spbkaizo/baudio/images/render.png

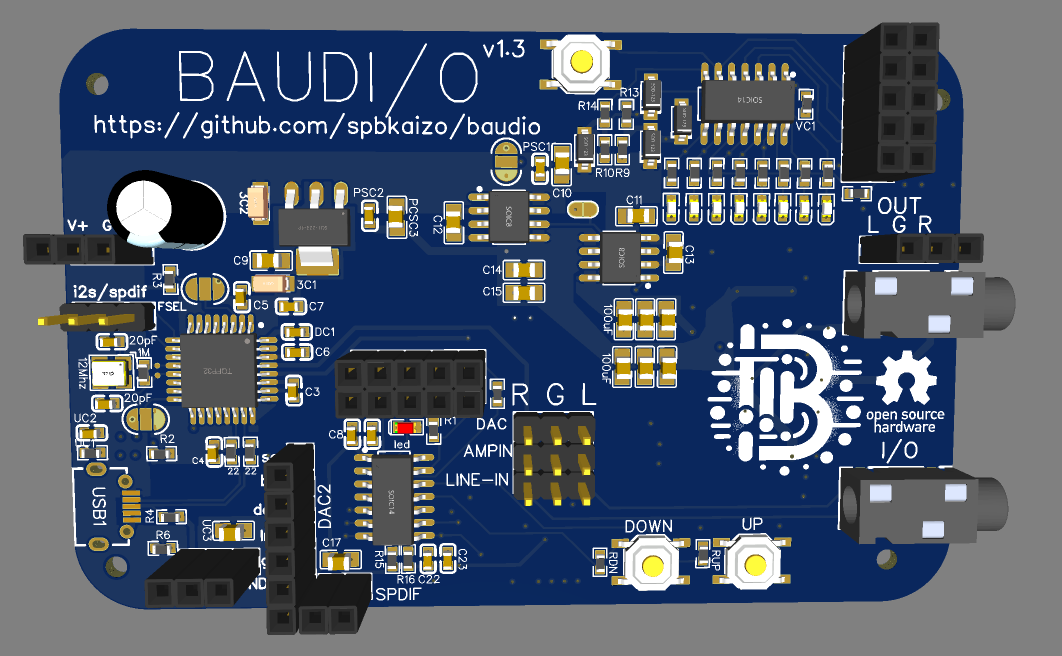
images/render.png
