spbkaizo/baudio/bom/BOM_BAUDIO_2024-05-25.csv

ID | Name | Designator | Footprint | Quantity | Manufacturer Part | Manufacturer | Supplier | Supplier Part | Price
1 | 10u | 3C1,3C2,BC1+,BC1-,VC4+,VC4- | CASE-A_3216 | 6 | CA45B-A-10V-10uF-K | CEC(振华新云) | LCSC | C136812 | 0.076
2 | LM2663MX/NOPB | 2663-1,2663-2 | SOIC-8_L4.9-W3.9-P1.27-LS6.0-BL | 2 | LM2663MX/NOPB | TI(德州仪器) | LCSC | C73869 | 2.647
3 | PCM2706CPJT | 2706 | TQFP-32_L7.0-W7.0-P0.80-LS9.0-BL | 1 | PCM2706CPJT | TI(德州仪器) | LCSC | C1520003 | 9.79
4 | HDR-F-2.54_2x5 | A1614VOL | HDR-F-2.54_2X5 | 1 |  |  | LCSC | C30419 | 0.055
5 | AD5242BRZ10-REEL7 | AD5242 | SOIC-16_L9.9-W3.9-P1.27-LS6.0-BL | 1 | AD5242BRZ10-REEL7 | ADI(亚德诺) | LCSC | C649396 | 4.785
6 | HDR-M-2.54_1x3 | AMPIN,DAC,FSEL,LINE-IN | HDR-M-2.54_1X3 | 4 |  |  | LCSC | C180248 | 0.175
7 | ATTINY1614-SSF | AT1614VOL,AT1614VU | SOIC-14_L8.7-W3.9-P1.27-LS6.0-BL | 2 | ATTINY1614-SSF | MICROCHIP(美国微芯) | LCSC | C614831 | 1.388
8 | 0.1u | BC2+,BC2-,PSC1,PSC2 | C0603 | 4 | 06035C104KAT2A | Kyocera AVX | LCSC | C88476 | 0.007
9 | Solder Short | BL,BR,SH3,SH4,SH5,SH6 | SOLDER SHORTING | 6
10 | 715 | BR2,LR1,LR2,RR1 | R0603 | 4 | 0603WAF7150T5E | UNI-ROYAL(厚声) | LCSC | C23238 | 0.001
11 | 100 | BR3,LR3 | R0603 | 2 | RT0603BRD07100RL | YAGEO(国巨) | LCSC | C122970 | 0.018
12 | 20p | C1,C2 | C0603 | 2 | AC0603JRNPO9BN200 | YAGEO(国巨) | LCSC | C149610 | 0.005
13 | 1uF | C1L,C1R,C2L,C2R | C1210 | 4 | ECPU1C105MA5 | PANASONIC(松下) | LCSC | C569895 | 0.398
14 | 1u | C3,C4,C5,C6 | C0603 | 4 |  |  | LCSC | C95843 | 0.007
15 | 22pf | C4L,C4R | C0603 | 2 | CC0603JRNPO9BN220 | YAGEO(国巨) | LCSC | C105620 | 0.002
16 | 0.1u | C7 | C0603 | 1 | CC0603MRY5V8BB104 | YAGEO(国巨) | LCSC | C519502 | 0.004
17 | 0.1u | C8,C23 | C0603 | 2 | ECPU1C104MA5 | PANASONIC(松下) | LCSC | C150376 | 0.256
18 | 1u | C9,C10,C11 | C0805 | 3 |  |  | LCSC | C95843 | 0.007
19 | 47u | C12,C13,C14,C15 | C0805 | 4 | CC0805MKX5R5BB476 | YAGEO(国巨) | LCSC | C109461 | 0.059
20 | 1u | C16,C22 | C0603 | 2 | CC0603KRX7R7BB105 | YAGEO(国巨) | LCSC | C106248 | 0.008
21 | 10u | C17,C18,C21 | C0805 | 3 | CGA0805X5R106K500MT | HRE(芯声) | LCSC | C6119889 | 0.058
22 | BZT52B4V7 | D1,D2,D3,D4 | SOD-123_L2.7-W1.6-LS3.7-RD | 4 |  |  | LCSC | C968129 | 0.019
23 | DAC2 | DAC2 | HDR-F-2.54_1X6 | 1 | 2.54-1*6P母 | BOOMELE(博穆精密) | LCSC | C40877 | 0.07
24 | 10u | DC1 | C0603 | 1 |  |  | LCSC | C19702 | 0.005
25 | 0 | DL1,DR1 | R0603 | 2
26 | HX TS5216A 250GF | DOWN,UP,VU-CTL | SW-SMD_4P-L5.2-W5.2-P3.70-LS6.4 | 3 | HX TS5216A 250gf | hanxia(韩下) | LCSC | C5143639 | 0.013
27 | HDR-F-2.54_1x3 | DUAL,H2 | HDR-F-2.54_1X3 | 2 |  |  | LCSC | C146690 | 0.076
28 | 0R | GND1,GND2 | R0603 | 2 | 0603WAF0000T5E | UNI-ROYAL(厚声) | LCSC | C21189 | 0.001
29 | HDR-F-2.54_2x5 | H1 | HDR-F-2.54_2X5 | 1 | DS1023-2*5SF11 | CONNFLY | LCSC | C92270 | 0.104
30 | Black headphone jack | I/O,OUT | AUDIO-TH_PJ-3200 | 2 | 320B直插 | BOOMELE(博穆精密) | LCSC | C18166 | 0.051
31 | SD | JP1,JP2,JP3 | SOLDER BRIDGE 3P UNBRIDGED | 3
32 | 10nF | LC1,LC2,RC1,RC2 | C0805 | 4 |  |  | LCSC | C178414 | 0.217
33 | KPH-1608SECK | LED1,LED2,LED3,LED4,LED5,LED6,LED7,LED8 | LED0603-RD | 8 | XL-1608UVC-04 | XINGLIGHT(成兴光) | LCSC | C7371898 | 0.01
34 | LED-0603_R | LED9 | LED0603_RED | 1 | KPH-1608SECK | Kingbright | LCSC | C5879293 | 0.118
35 | LM1117GS-3.3-HTC | LM1117 | LM1117GS-3.3-HTC-SOT-223 | 1 | LD1117AG-33-AA3-A-R | UTC | LCSC | C71121 | 0.062
36 | HDR-M-2.54_1x3 | OUT2 | HDR-F-2.54_1X3 | 1 |  |  | LCSC | C180248 | 0.175
37 | 10u | PCSC3,UC3 | C0805 | 2 | CL21A106KOQNNNE | SAMSUNG(三星) | LCSC | C1713 | 0.008
38 | 1k | R1 | R0603 | 1 |  |  | LCSC | C203217 | 0.003
39 | 100k | R1L,R1R,R2L,R2R | R0603 | 4 | ERA6AEB104V | PANASONIC(松下) | LCSC | C192074 | 0.071
40 | 10k | R2,RDN | R0603 | 2 | HoAR0603-1/10W-10KR-0.1%-TCR25 | Milliohm(毫欧) | LCSC | C5123581 | 0.074
41 | 10K | R3,R22,RUP | R0603 | 3
42 | 1k | R3L,R3R,RLED1,RLED2,RLED3,RLED4,RLED5,RLED6,RLED7,RLED8 | R0603 | 10 | CR0603-FX-1001ELF | BOURNS | LCSC | C203217 | 0.003
43 | 1k5 | R4 | R0603 | 1 | RC0603FR-071K5L | YAGEO(国巨) | LCSC | C114668 | 0.001
44 | 2.8k | R4L,R4R | R0603 | 2 | CMP0603AFX-1002ELF | BOURNS | LCSC | C1880697 | 0.278
45 | 470 | R5,R17 | R0603 | 2 | CR0603F470RP05Z | EVER OHMS(天二科技) | LCSC | C881392 | 0.002
46 | 100 | R5L,R5R | R0603 | 2 | QR0603J0R00P05Z | EVER OHMS(天二科技) | LCSC | C176152 | 0.003
47 | 1M | R6,X1R | R0603 | 2 | SCR0603F1M | VO(翔胜) | LCSC | C3016422 | 0.001
48 | 100k | R7,R8 | R0603 | 2 | RT0603BRE07100KL | YAGEO(国巨) | LCSC | C326758 | 0.023
49 | 10k | R9,R10,R11,R12,R13,R14,R20,R21 | R0603 | 8 | ERJ3EKF1002V | PANASONIC(松下) | LCSC | C191124 | 0.005
50 | 4.7K | R15,R16 | R0603 | 2 | ERJ3EKF4701V | PANASONIC(松下) | LCSC | C192166 | 0.004
51 | 1k | R18,R19 | R0603 | 2
52 | HDR-F-2.54_1x2 | SPDIF | HDR-F-2.54_1X2 | 1 |  |  | LCSC | C124375 | 0.022
53 | 0.1u | UC1,VC1 | R0603 | 2 | ECPU1C104MA5 | PANASONIC(松下) | LCSC | C150376 | 0.256
54 | 1u | UC2,VC5+,VC5- | C0603 | 3 | 06033D105MAT2A | Kyocera AVX | LCSC | C597124 | 0.032
55 | HX USB-MICR XNJ ZB | USB1 | MICRO-USB-SMD_HX-USB-MICRO-XNJ-JB | 1 | HX USB-MICR XNJ ZB | hanxia(韩下) | LCSC | C18357557 | 0.028
56 | 680uF | USBC1 | CAP-D6.3×F2.5 | 1 |  |  | LCSC | C2990893 | 0.095
57 | 22 | USBR1,USBR2 | R0603 | 2 | RTT0322R0FTP | RALEC(旺诠) | LCSC | C103434 | 0.001
58 | 100u | VC1+,VC1-,VC2+,VC2-,VC3+,VC3- | C0805 | 6 |  |  | LCSC | C141660 | 0.358
59 | 0.1u | VC6+,VC6- | C0603 | 2 |  |  | LCSC | C88476 | 0.007
60 | 12MHz | X1 | OSC-SMD_4P-L3.2-W2.5-BL | 1 | X322512MSB4SI | YXC(扬兴晶振) | LCSC | C9002 | 0.057
61 | LM4562MA/NOPB | BUF | SOIC-8_L4.9-W3.9-P1.27-LS6.0-BL | 1 | LM4562MA/NOPB | TI(德州仪器) | LCSC | C1348033 | 5.818
62 | LM4562 | OPA | SOIC-8_L4.9-W3.9-P1.27-LS6.0-BL | 1 | LM4562MAX/NOPB | TI(德州仪器) | LCSC | C57367 | 1.397
