spbkaizo/baudio/(threads)

Thread 1 (2024-11-08):

Suggestion: USB-C Connector

Ardakilic, 2024-11-08:
Hello,

Can the connector be USB-C ? Micro usb connectors tend to break, at least for me, a lot, and I believe with 5.1k ohm resistors included with the connector, regardless of the voltage, PD could negotiate with the board and it could supply 5v, just like micro usb does to the rest of the board.

Thanks in advance,
