spbkaizo/baudio/vu-meter/adc.c

#include "adc.h"
#include <util/delay.h>

#define SAMPLE_COUNT 100

void setup_adc() {
    /* Select the reference before enabling the ADC. REFSEL is a bit group,
       so clear it first: |= alone cannot move the selection off a value that
       is already set, and setup_adc() is called more than once. Options are
       0V55, 1V1, 1V5, 2V5 and 4V34; 4V34 suits the DC-biased audio input on
       this board. */
    VREF.CTRLA = (VREF.CTRLA & ~VREF_ADC0REFSEL_gm) | VREF_ADC0REFSEL_4V34_gc;

    // Set the ADC prescaler to 16 (20 MHz / 16 = 1.25 MHz ADC clock)
    ADC0.CTRLC = ADC_PRESC_DIV16_gc | ADC_REFSEL_INTREF_gc;

    /* Lengthen the sampling period. The default of two ADC clocks is short
       for the high source impedance of the audio divider feeding these
       inputs, which leaves the sample capacitor incompletely charged and the
       reading low. */
    ADC0.SAMPCTRL = 16;

    // Enable the ADC
    ADC0.CTRLA = ADC_ENABLE_bm;
}

uint16_t read_adc(uint8_t channel) {
    // Select the ADC channel
    ADC0.MUXPOS = channel;

    // Start the conversion
    ADC0.COMMAND = ADC_STCONV_bm;

    // Wait for the conversion to complete
    while (!(ADC0.INTFLAGS & ADC_RESRDY_bm));

    // Clear the interrupt flag
    ADC0.INTFLAGS = ADC_RESRDY_bm;

    // Return the ADC result
    return ADC0.RES;
}

void calibrate_adc_baseline(uint8_t channel, uint16_t *baseline) {
    uint32_t sum = 0;
    uint16_t sample;

    // Take multiple samples
    for (int i = 0; i < SAMPLE_COUNT; i++) {
        sample = read_adc(channel);
        sum += sample;
        _delay_ms(5);  // Delay to allow ADC to settle
    }
    *baseline = sum / SAMPLE_COUNT;
}
