spbkaizo/baudio/vu-meter/spectrum.h

// spectrum.h

#ifndef SPECTRUM_H
#define SPECTRUM_H

#include <stdint.h>

// Initializes the spectrum analyzer module.
void spectrum_init();

// Updates the spectrum analyzer, should be called regularly.
void spectrum_update();

#endif // SPECTRUM_H
