spbkaizo/baudio/(commit log)

2024-03-19 add schematics and gerber for v1.1
2024-03-19 bom still needs work
    [BOM_Bcard2024_2024-03-19.csv]
2024-03-19 added schematics to docs
2024-03-20 added pcb
2024-03-20 added pcb to main page
2024-03-20 fixed up and finalised bom
    [BOM_BAUDIO_v1.1.xlsx, BOM_Bcard2024_2024-03-19.csv]
2024-03-20 fix out of stock item in bom
    [BOM_BAUDIO_v1.1.xlsx]
2024-03-23 added PCM5102A datasheet for breakout board
2024-03-29 update schematic
2024-03-30 pull gerber - design broken
2024-05-17 add some datasheets, add circuitjs amp
2024-05-17 add circuitjs link
2024-05-17 update to v1.3 schematics
2024-05-22 added usart adc debugger, extended vu-meter code
2024-05-24 moved to Voltage reference at 4.34V for the VU meter - seems to give a better response.
2024-05-25 Resync gerbers and update docs
2024-05-25 Update BOM
    [BOM_BAUDIO_2024-05-25.csv, BOM_BAUDIO_v1.1.xlsx]
2026-09-16 fixfft: populate the missing Sinewave table
    The table was left as a placeholder comment, so all 192 entries were
    zero. Every twiddle factor read by fix_fft() was therefore 0 and the
    transform returned garbage, making spectrum analyzer mode inoperable.
    Generated as round(127 * sin(2*pi*i / N_WAVE)) for i in 0..191, which
    is the table the original fix_fft expects: peak +127 at index 64 and a
    zero crossing at index 128, so the cosine term read at the N_WAVE/4
    offset lines up correctly.
    [fixfft.c]
2026-09-16 timer: stop millis() from unconditionally re-enabling interrupts
    millis() ended its critical section with sei() rather than restoring
    the previous interrupt state. It is called from inside
    PORTB_PORT_vect, where that sei() re-enables interrupts within the
    handler and allows the button ISR to re-enter itself, nesting until
    the stack is exhausted. A bouncing switch was enough to trigger it.
    Save SREG on entry and restore it after the read, so the flag is left
    as the caller had it.
2026-09-16 volume-control: check I2C acknowledgement and bound the wait loops
    i2c_start() and i2c_write() spun on TWI_WIF_bm without ever testing
    RXACK, ARBLOST or BUSERR, so a device that failed to acknowledge left
    the firmware spinning forever with the bus still held. Both now report
    failure, every wait is bounded by a guard count, and ad5242_set_wiper()
    always issues a STOP so a failed transfer releases the bus.
    MBAUD used (F_CPU - 2*f_SCL) / (2*f_SCL), which is not the tinyAVR
    formula and gave 15. The datasheet expression F_CPU/(2*f_SCL) - 5
    gives 11, for roughly 98 kHz.
    current_index becomes uint8_t and the array bound moves to a named
    VOLUME_STEPS constant, silencing a signed/unsigned compariso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
    [main.c]
2026-09-16 vu-meter: build vu2.c instead of vu1.c
    main.c includes vu2.h and calls volume_meter_task() with two channel
    arguments, but the Makefile compiled vu1.c, whose volume_meter_task()
    takes one. Both files define the same two symbol names, so the linker
    bound the two-argument call to the one-argument function without
    complaint: the right-channel argument was passed in a register the
    callee never read, and all eight LEDs were driven from the left
    channel against baseline_left alone.
    Building vu2.c gives the intended split display, LEDs 0-3 for left and
    4-7 for right, each against its own calibrated baseline.
    Verified on target: avr-gcc -mmcu=attiny1614 links clean at 5876 bytes
    flash (36%) and 63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
2026-09-16 build: point both Makefiles at the Microchip ATtiny DFP
    avr-gcc has no built-in support for the tinyAVR 0/1-series, so
    building for the ATtiny1614 failed with "device type not defined" and
    every register name came back undeclared. The device specs and headers
    come from Microchip's ATtiny DFP instead.
    Both Makefiles now pass -B $(DFP)/gcc/dev/$(MCU) and -isystem
    $(DFP)/include, defaulting to ~/local/avr-dfp and overridable with
    make DFP=/path/to/pack. -Wall is on for both, vu-meter links -lm for
    the sqrt and log10 calls in spectrum.c, and the stale AVR_LIBC_PATH
    that pointed at a non-existent tree is gone.
    make now produces a flashable main.hex in both projects.
    Object files, ELF and listi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
2026-09-16 spectrum: stop writing brightness values into a one-bit LED API
    set_led_state() ORs its argument into PORTA/PORTB at the LED's bit
    position, so it must be passed 0 or 1. spectrum_update() passed a
    0-255 magnitude, and (state << PIN1_bp) then spilled across unrelated
    pins: a magnitude of 255 set PORTB bits 1-7, which includes PB3, the
    mode button input, and PB7. A magnitude of 128 shifted clean off the
    top of the byte and left the LED dark at full scale.
    The bin-to-LED mapping was wrong as well. Folding 128 bins onto 8 LEDs
    with i % LED_COUNT meant each LED was written 16 times per frame and
    kept only the last write, so the display showed bins 120-127 alone,
    the top of the spectrum. Bins are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
    [main.c, spectrum.c, spectrum.h]
2026-09-16 adc-debug: fix USART baud rate calculation and TX/RX pins
    The baud register used the classic ATmega expression
    F_CPU/(16*baud) - 1, which gave 9. On the tinyAVR 0/1-series BAUD is a
    16-bit value with six fractional bits, so 9 asks for roughly 8.9 Mbaud
    against a target of 115200. The correct expression, 64*F_CPU/(16*baud),
    gives 694 for 115274 baud, an error of 0.06 percent. The & 0x0FFF mask
    would have truncated that value and is gone.
    usart_init() also drove PA1 and PA2, which carry no USART signal on
    this part. The device definition puts USART0 TXD on PB2 and RXD on PB3
    in the default port mux position, so nothing was ever transmitted.
    The local #define F_CPU is removed; it appeared aft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
    [usart.c]
2026-09-16 adc: write the reference select as a field and lengthen sampling
    VREF.CTRLA was written with |=, which cannot move REFSEL off a value
    that is already set because the field is three bits wide, not a flag.
    It happened to produce 4V34 from the reset state, but setup_adc() runs
    more than once and any later change of reference would have silently
    OR-ed into a wrong selection. The field is now masked before the write.
    The reference is also selected before the ADC is enabled, and
    SAMPCTRL extends the sampling period beyond the two-clock default,
    which is short for the source impedance of the audio divider driving
    these inputs and biases readings low.
    spectrum_init() no longer calls setup_adc(). m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
    [adc.c, spectrum.c]
2026-09-16 vu-meter: wrap the mode counter at the number of modes compiled in
    The button handler advanced the mode with a hardcoded % 5. That is
    right for the five LED modes, but a USE_LCD build has only three, so
    the counter could reach 3 and 4, which no case in the LCD switch
    handles. The display then stopped updating until the button was
    pressed enough times to wrap past them.
    MODE_COUNT is defined alongside the mode list in main.h and follows
    whichever set is compiled in, five or three.
    Removes last_state, which was declared volatile and never read.
    Verified both paths build for the target; the USE_LCD preprocessor
    output resolves the wrap to % 3.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
    [main.c, main.h]
2026-09-16 cylon: drive the LEDs through set_led_state and wire up middle-out
    cylon.c was compiled into every build but never called: MODE_MIDDLE_OUT
    ran the volume meter instead, so the fifth mode duplicated the second.
    The effect also wrote PORTA directly, setting PA1 to PA5. The eight
    LEDs are split across two ports and are not in pin order, so those
    writes lit the wrong LEDs, missed the one on PA6, and never touched
    the two on PORTB. It now goes through set_led_state() like every other
    effect.
    Rewritten as the middle-out sweep the mode name describes: the two
    centre LEDs light first and the mirrored pair moves outwards to the
    ends, then back in. The loops poll mode so a button press leaves the
    ef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
    [cylon.c, main.c]
2026-09-16 lcd: record the column count and clamp the cursor column
    lcd_begin() took cols and ignored it, so lcd->cols held whatever
    lcd_init() had already stored and the parameter was dead. It is now
    assigned there as well, which makes lcd_begin() usable on its own.
    lcd_set_cursor() clamped row but not col, so a column past the end of
    the line walked the DDRAM address into the next row's buffer. Both are
    clamped now.
2026-09-16 vu-meter: rectify before averaging and stop the level wrapping
    Two faults in the level calculation.
    The lit-LED count was computed as abs(normalized) * 4 / SENSITIVITY and
    cast to uint8_t with nothing clamping it. The product passes 255 once
    the deviation reaches 192 counts, so the cast wrapped and a loud
    passage blanked the meter at the moment it should have been full. It
    then cycled through the range as the signal rose further. The count is
    now computed in a wider type and saturates at four LEDs per channel.
    The window also averaged raw samples and subtracted the baseline
    afterwards, which lets the halves of the waveform cancel according to
    where the window falls in the cycle. Each sampl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
2026-09-16 fixfft: clamp FIX_MPY and take int8_t rather than char
    FIX_MPY returned the rounded product without a range check. With both
    operands at -128 the rounded value is +128, which does not fit in a
    signed 8-bit result and wraps to -128, inverting the sign inside the
    butterfly. One operand always comes from the sine table, whose
    magnitude never exceeds 127, so the case is not reachable today, but
    the biased sample range does include -128 and the clamp is cheap.
    The signature moves from char to int8_t. Plain char has
    implementation-defined signedness, and the arithmetic here relies on
    it being signed.
    Verified against the C logic in a host model: pure tones at bins 4, 8,
    16 and 32 each produce th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
    [fixfft.h]
2026-09-16 volume-control: only step the volume on a write the pot acknowledged
    The LED was lit on any press, before the range check, so it signalled
    success at the ends of the travel where nothing moved and when the pot
    never acknowledged. It now flashes only when a step actually took
    effect, which makes it a usable indication that the I2C write landed.
    current_index is advanced only after apply_volume() reports success.
    Incrementing first left the stored index describing a wiper position
    the device had never taken, and every later step compounded it.
    Pressing both buttons together took whichever branch was tested first;
    that combination is now ignored.
    The pin comments named the opposite button fo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
2026-09-16 adc: correct the channel comment and record the right-channel conflict
    Both headers labelled AIN10 as PB2. The device definition puts AIN10
    on PB1; PB2 has no ADC channel on this part, whose analogue inputs are
    AIN0-AIN7 on PA0-PA7 plus AIN10 on PB1 and AIN11 on PB0.
    That leaves the right channel wrong in two independent ways. The VU
    meter schematic routes the adcro net to PB2, which cannot be sampled
    at all, while the firmware selects AIN10, which is PB1, a pin main.c
    drives as an output for LED 0. The left channel is consistent: AIN7 is
    PA7 and the schematic agrees.
    No behaviour is changed. Selecting a different channel without the
    board in hand would only move the problem to another wro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
    [adc.h]
2026-09-16 docs: record the v1.4 board faults found while fixing the firmware
    HARDWARE-ISSUES.md captures two findings from tracing the VU meter
    schematic against the ATtiny1614 device definition, so they are not
    re-derived later.
    HW-1: the sheet routes the right channel net adcro to PB2, which has
    no ADC channel on this part. The firmware independently selects AIN10,
    which is PB1, a pin driven as an output for LED 0. Both are wrong, and
    every ADC-capable pin is already committed, so a fix has to give
    something up. Four options are set out with a recommendation: move the
    right channel to PB1 and put that LED on PB2, which needs one net swap
    and one line of firmware.
    HW-2: PB2 is also the default USAR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
    [usart.c]
2026-09-16 ci: build the firmware and publish the hex files
    Builds all three ATtiny1614 projects on push, pull request and manual
    dispatch. Every run uploads the hex files as artefacts; pushing a
    version tag also attaches them to a GitHub Release with flashing
    instructions, which is the copy meant for distribution.
    avr-gcc cannot target the tinyAVR 0/1-series on its own, so the job
    fetches Microchip's ATtiny DFP, trims it to the gcc and include trees
    it actually needs, 129 MB down to 16 MB, and caches it against the
    pinned pack version. A small probe compiles a register access before
    the real build, so a toolchain that cannot use the pack reports itself
    rather than appearing as undeclared-register err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
2026-09-16 docs: tell the builder how to program the microcontrollers
    BUILD.md walked through populating the whole board and stopped at
    "Anything Missing?", never mentioning that the two ATtiny1614s arrive
    blank. Someone following it start to finish ended with a finished board
    whose LEDs did nothing and no indication that a programming step
    existed.
    Adds a Stage 2 section covering what a UPDI programmer is, where to get
    the prebuilt .hex files, and the avrdude command for each of the two
    chips, noting they are physically separate and each needs its own
    connection. A Proof of life subsection records what a correctly
    programmed board does at power-up: the volume control blinks BAUDIO in
    Morse, and the V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
2026-09-16 docs: specify the board change that makes the right channel readable
    PCB-REV-1.5.md sets out the single edit for the next board revision:
    swap the nets on pins 7 and 8 of the VU meter ATtiny1614, so the
    adcro audio input lands on PB1, which has an ADC channel, and the
    rled1 LED moves to PB2, which does not need one.
    Covers the reasoning, the steps in EasyEDA, routing notes for the
    analogue line, the firmware changes to make at the same time, and how
    to verify the result on an assembled board. Also records that HW-2,
    the PB2 collision with the serial debug output, is resolved by the
    same change.
    The two firmware changes were applied to a scratch copy and compiled
    for the target to confirm t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
2026-09-18 docs: record what the v1.3 to v1.4 revision fixed
    The v1.4 board added a resistor to ground on each of the two audio
    inputs. On the v1.4 schematic those are R11 and R12, 10k each, which
    pair with R9 and R10 from +5V to bias each VU meter input to mid-rail.
    Without them the input floats high and the ADC has no usable baseline.
    Marked as likely rather than confirmed: the designators are inferred
    from the v1.4 topology and the author's recollection, and no v1.3
    schematic is in this repository to check against.
    The practical consequence is recorded either way. A v1.3 board carries
    this fault as well as HW-1, so it cannot be used to test the right
    channel pin allocation.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
2026-09-18 docs: correct the v1.3 to v1.4 fix and keep a photo of the bodge
    A photograph of a built v1.3 board shows the fix as two hand-soldered
    through-hole resistors on the underside, banded brown-black-orange-gold
    for 10k, joined at one end and fanning to two pads beside the AD5242.
    That places the change on the volume control, not the VU meter. An
    earlier note here guessed R11 and R12 in the VU meter's bias divider
    from the v1.4 schematic alone; the photograph contradicts it. The
    AD5242's B terminals want to sit at ground for the part to work as a
    volume divider, and 10k matches the element value of the AD5242BRZ10
    fitted.
    Still not confirmed against a v1.3 schematic or a netlist, so the
    B1/B2 a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
2026-09-18 docs: establish that HW-1 is original to the design
    The author confirms the two ground resistors were the only change
    between v1.3 and v1.4. That has two consequences worth recording.
    A v1.3 board with the bodge fitted is electrically equivalent to a
    v1.4 and can be used to test HW-1; without it the difference is
    confined to the volume control, which HW-1 does not involve, so even
    an unmodified v1.3 board shows the fault.
    HW-1 itself has never been fixed. The VU meter sheet at rev 1.0, dated
    2024-02-28 and recoverable from 63e706b, carries the same pin
    arrangement as v1.4, so the right channel has not worked on any board
    built from this design. The earlier note claiming a v1.3 board could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
